KyivRoboMagic/WRO-2024/KyivRoboMagic team photo 2024.jpg

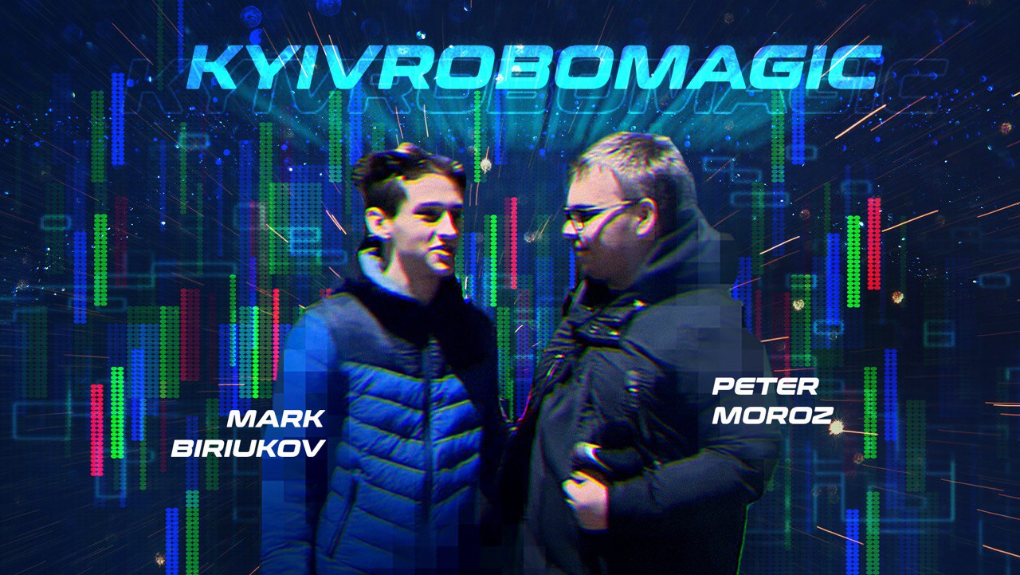
KyivRoboMagic team photo 2024.jpg
