KyivRoboMagic/WRO-2024/Robot.jpg

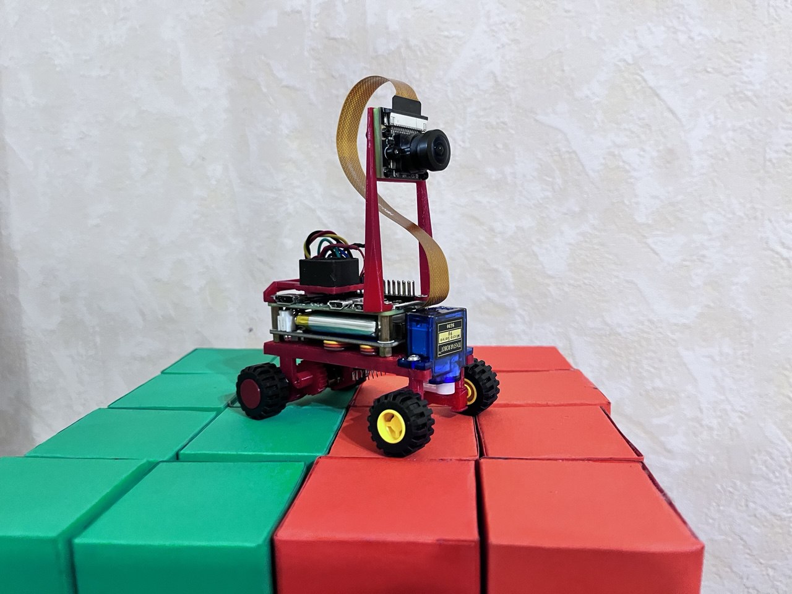
Robot.jpg
