KyivRoboMagic/WRO-2024/README.md

This is WRO 2024 Future Engineers Github repository of Ukrainian team KyivRoboMagic.
