KyivRoboMagic/WRO-2024/Robot STL files/README.txt

Robot parts are designed by KyivRoboMagic team, and are 3D printed
