KyivRoboMagic/WRO-2024/Robot photos/Robot Back.jpg

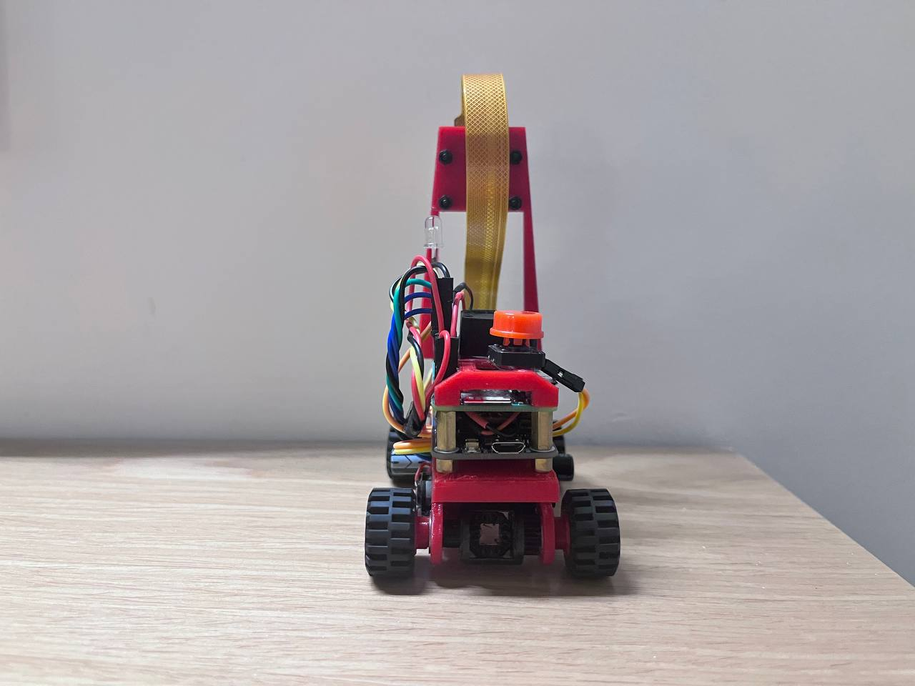
Robot photos/Robot Back.jpg
