KyivRoboMagic/WRO-2024/Robot photos/Robot Bottom.jpg

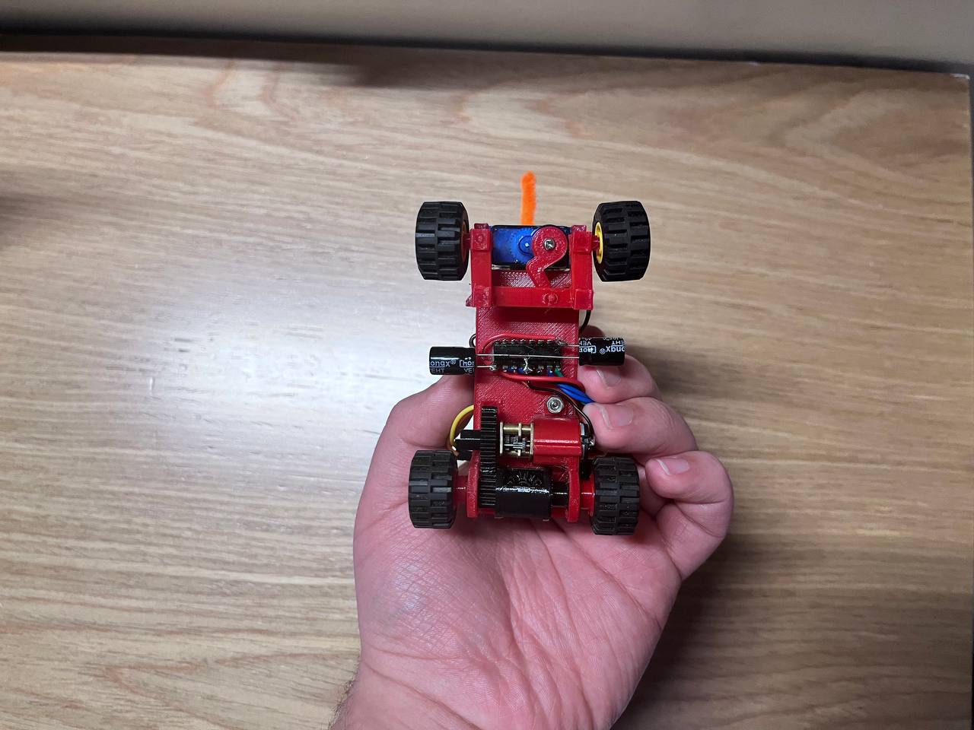
Robot photos/Robot Bottom.jpg
