KyivRoboMagic/WRO-2024/Robot photos/Robot Forward.jpg

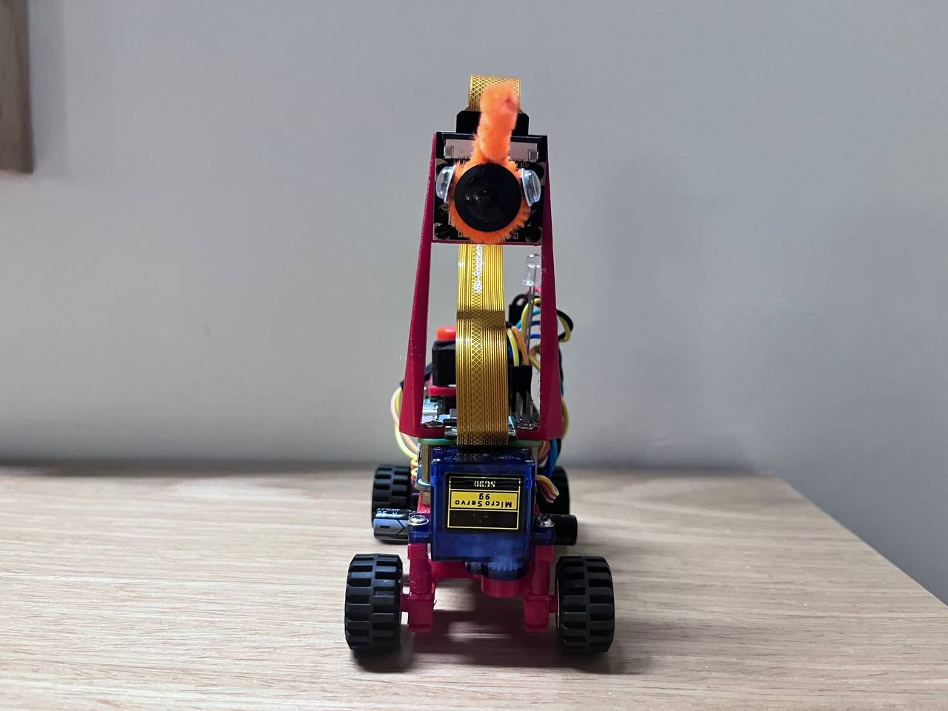
Robot photos/Robot Forward.jpg
