KyivRoboMagic/WRO-2024/Robot photos/Robot Left.jpg

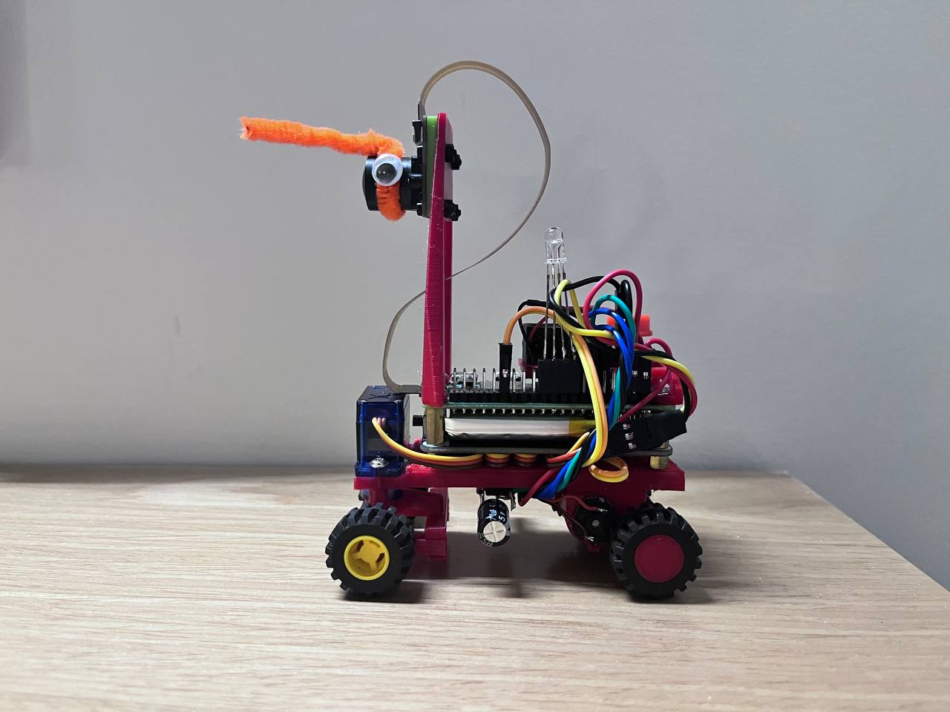
Robot photos/Robot Left.jpg
