KyivRoboMagic/WRO-2024/Robot photos/Robot Photo.jpg

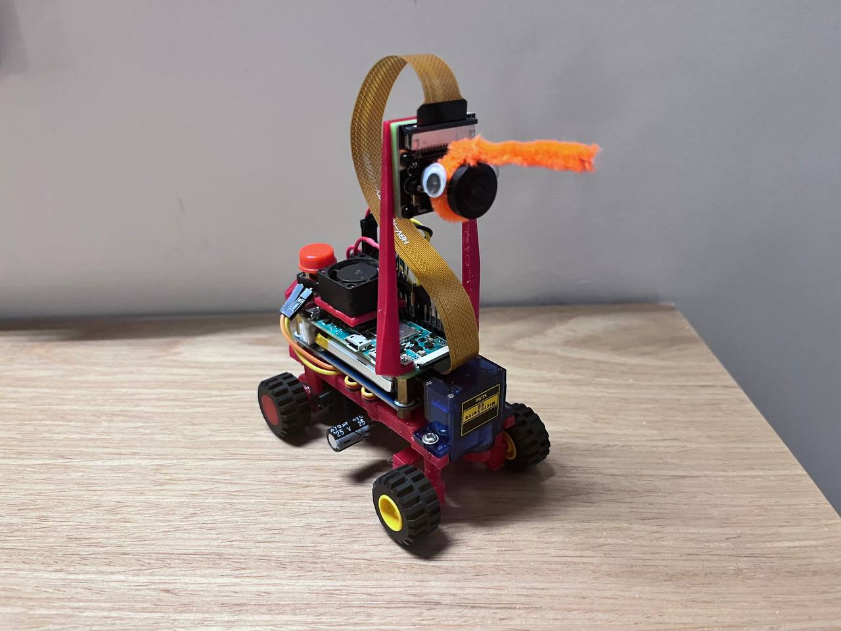
Robot photos/Robot Photo.jpg
