KyivRoboMagic/WRO-2024/Robot photos/Robot Right.jpg

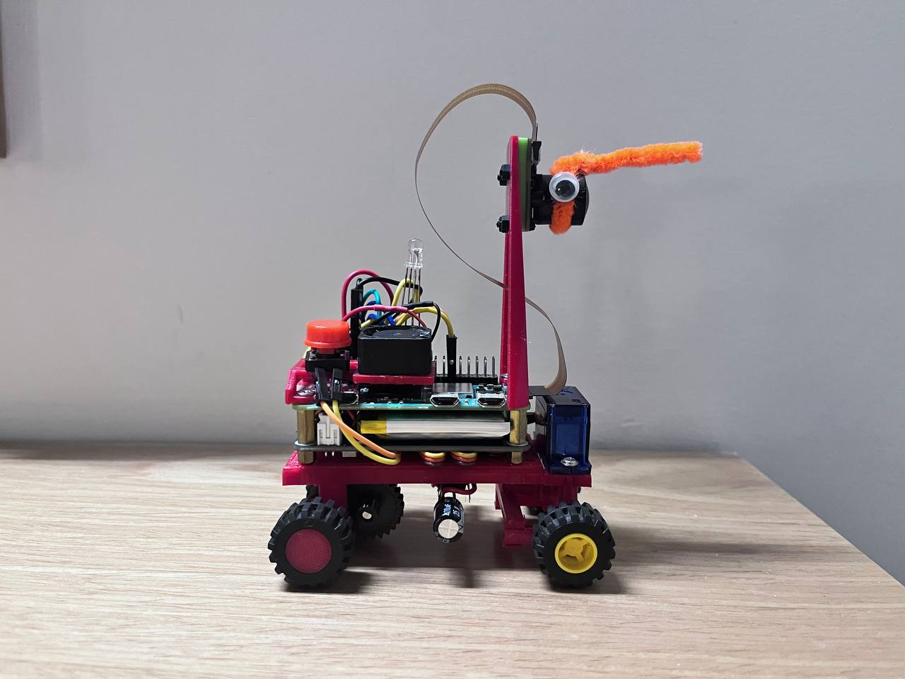
Robot photos/Robot Right.jpg
