KyivRoboMagic/WRO-2024/Robot photos/Robot Top.jpg

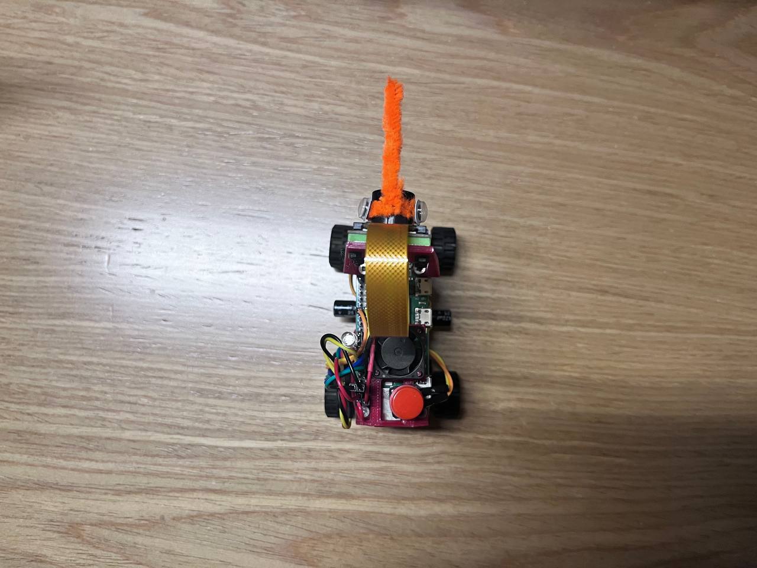
Robot photos/Robot Top.jpg
