KyivRoboMagic/WRO-2024/Robot_photo_new.jpg

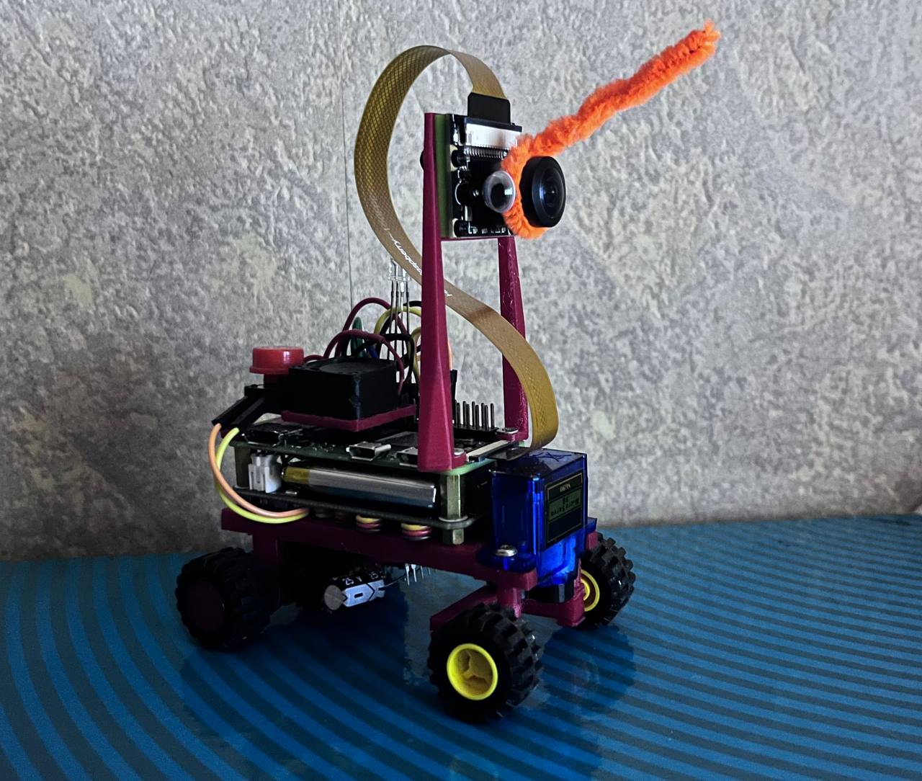
Robot_photo_new.jpg
