KyivRoboMagic/WRO-2024/Robot STL files/Turn Assembly v7.stl

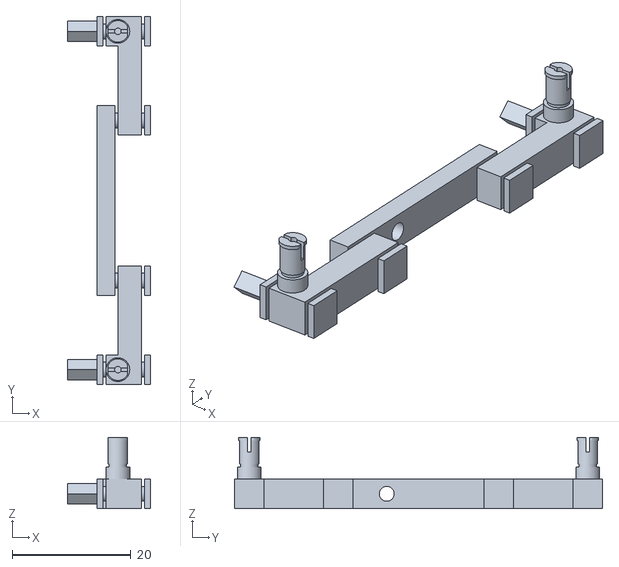
[picture p26: CAD file, 2024-11-27]
Robot STL files/Turn Assembly v7.stl
14.0 x 62.0 x 12.0
