KyivRoboMagic/WRO-2024/Robot STL files/Door.stl

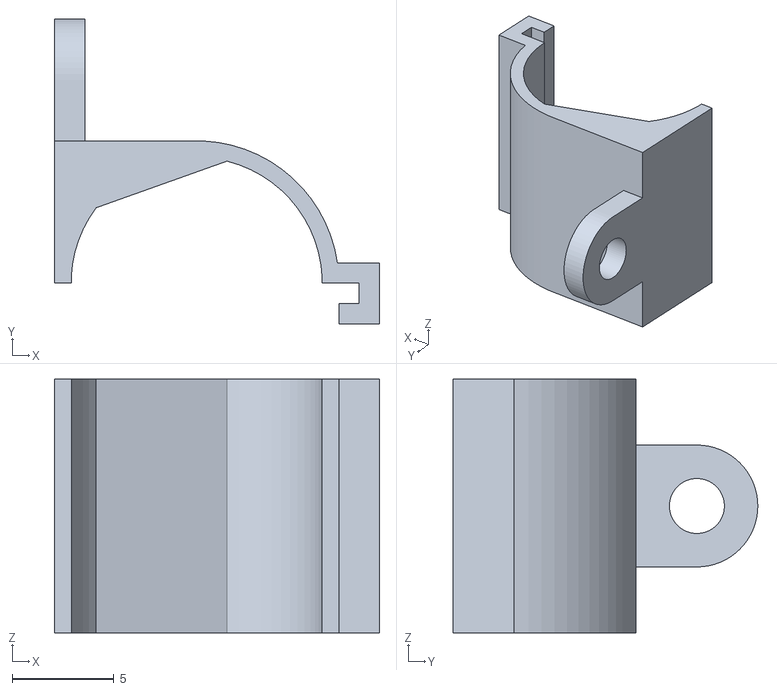
[picture p27: CAD file, 2024-11-27]
Robot STL files/Door.stl
16.0 x 15.0 x 12.5
