KyivRoboMagic/WRO-2024/Robot STL files/Fan Connector.stl

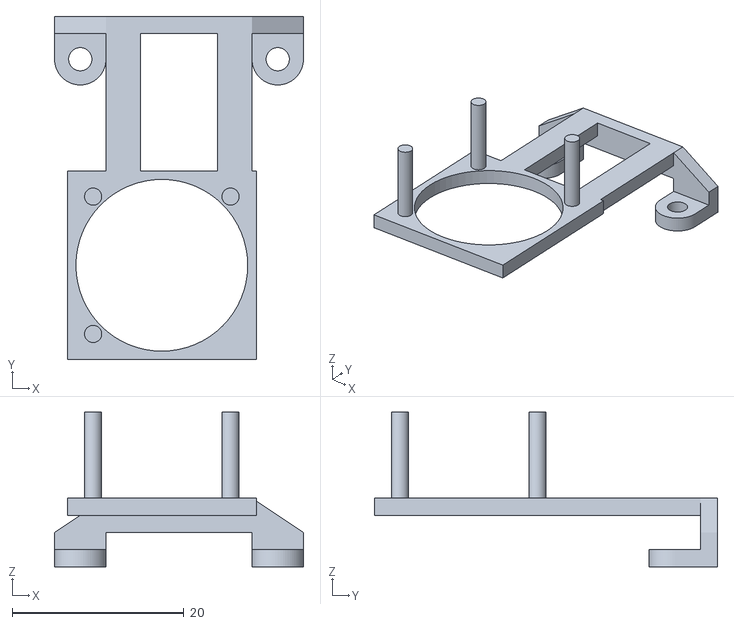
[picture p28: CAD file, 2024-11-27]
Robot STL files/Fan Connector.stl
29.0 x 40.0 x 18.0
