KyivRoboMagic/WRO-2024/Robot STL files/Camera Connector.stl

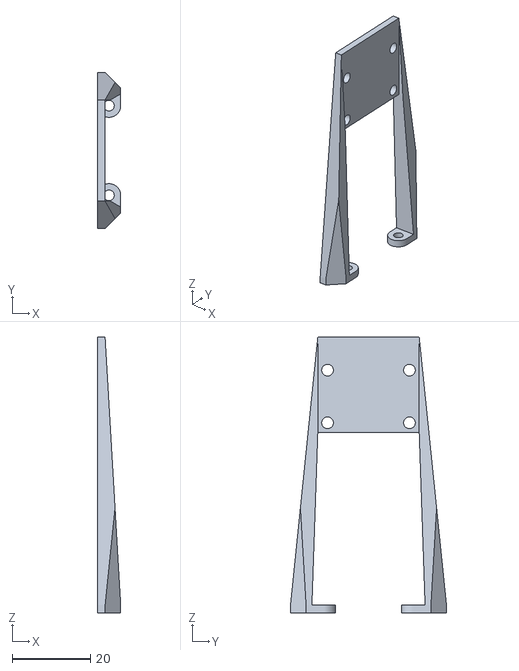
[picture p29: CAD file, 2024-11-27]
Robot STL files/Camera Connector.stl
6.00 x 40.0 x 70.8
