KyivRoboMagic/WRO-2024/Robot STL files/Base.stl

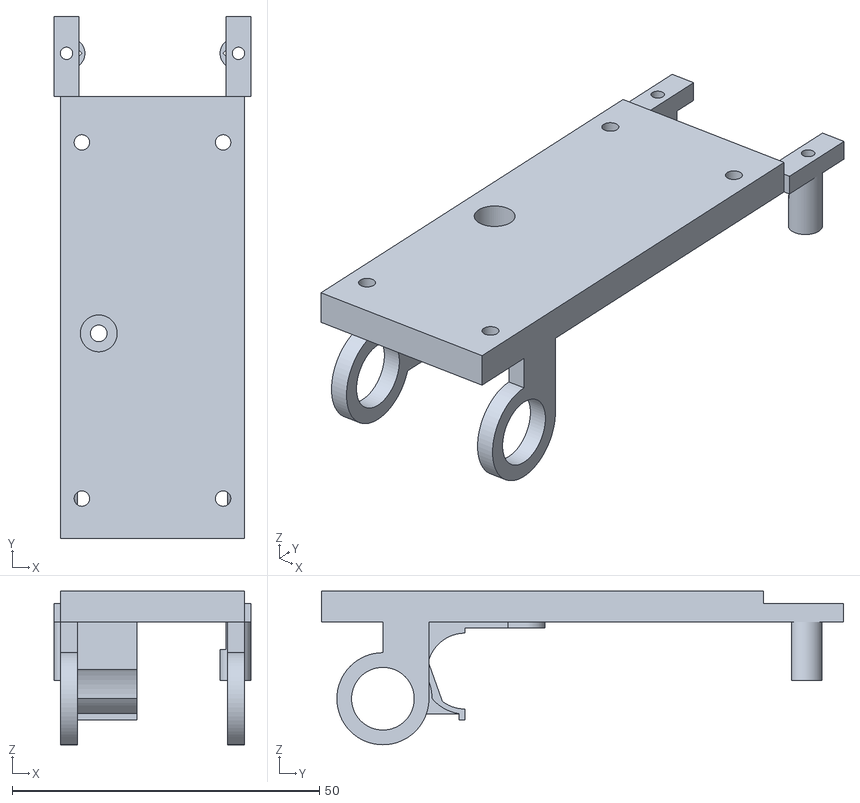
[picture p30: CAD file, 2024-11-27]
Robot STL files/Base.stl
32.0 x 85.0 x 25.0
