KyivRoboMagic/WRO-2024/Robot STL files/Motor Gear.stl

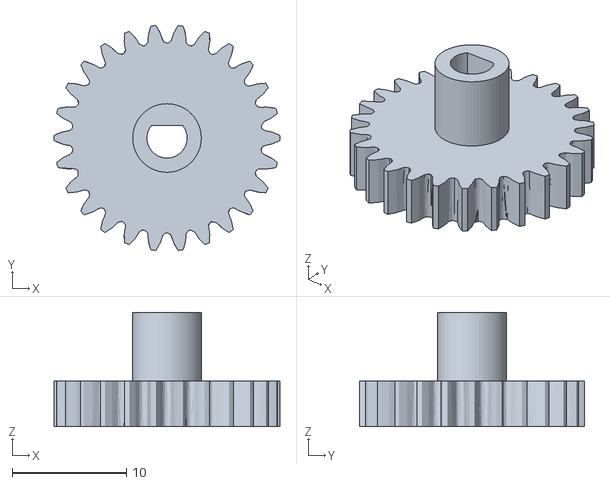
[picture p31: CAD file, 2024-11-27]
Robot STL files/Motor Gear.stl
19.8 x 19.7 x 10.0
