KyivRoboMagic/WRO-2024/Robot STL files/Axle Gear v3.stl

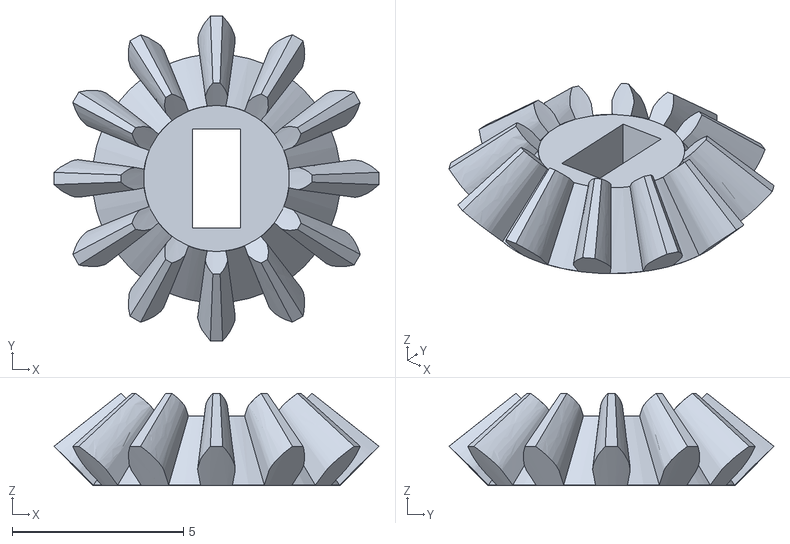
[picture p32: CAD file, 2024-11-27]
Robot STL files/Axle Gear v3.stl
9.50 x 9.50 x 2.70
