KyivRoboMagic/WRO-2024/Robot STL files/Differential.stl

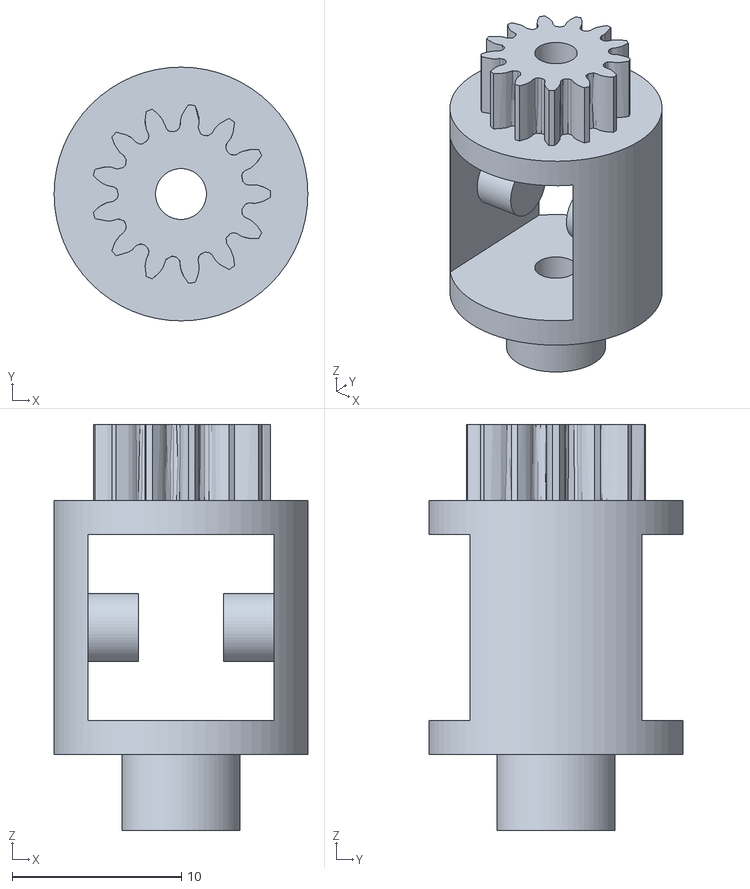
[picture p33: CAD file, 2024-11-27]
Robot STL files/Differential.stl
15.0 x 15.0 x 24.0
