KyivRoboMagic/WRO-2024/Robot STL files/Wheel Axle v8b.stl

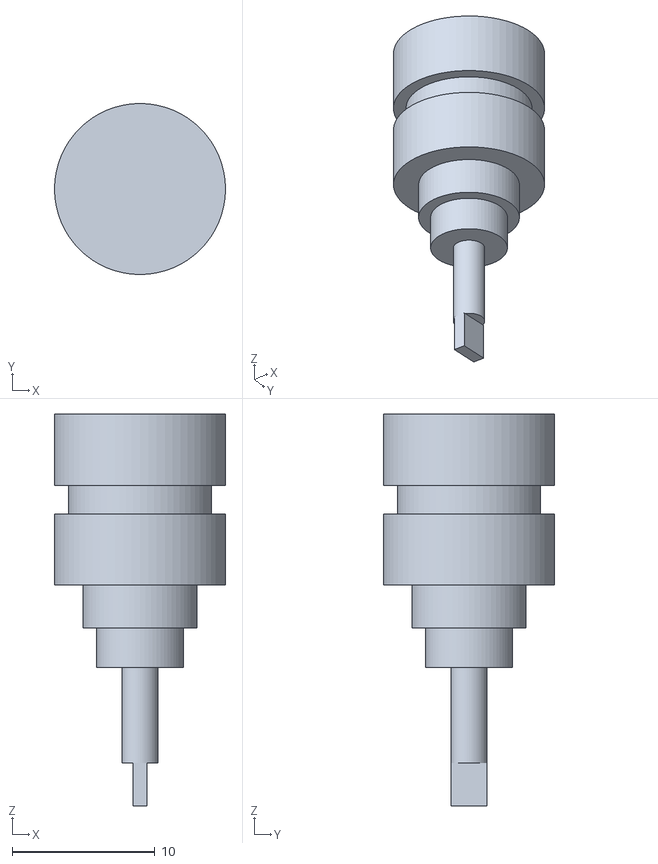
[picture p34: CAD file, 2024-11-27]
Robot STL files/Wheel Axle v8b.stl
12.0 x 12.0 x 27.5
