KyivRoboMagic/WRO-2024/Robot STL files/Servo Arm.stl

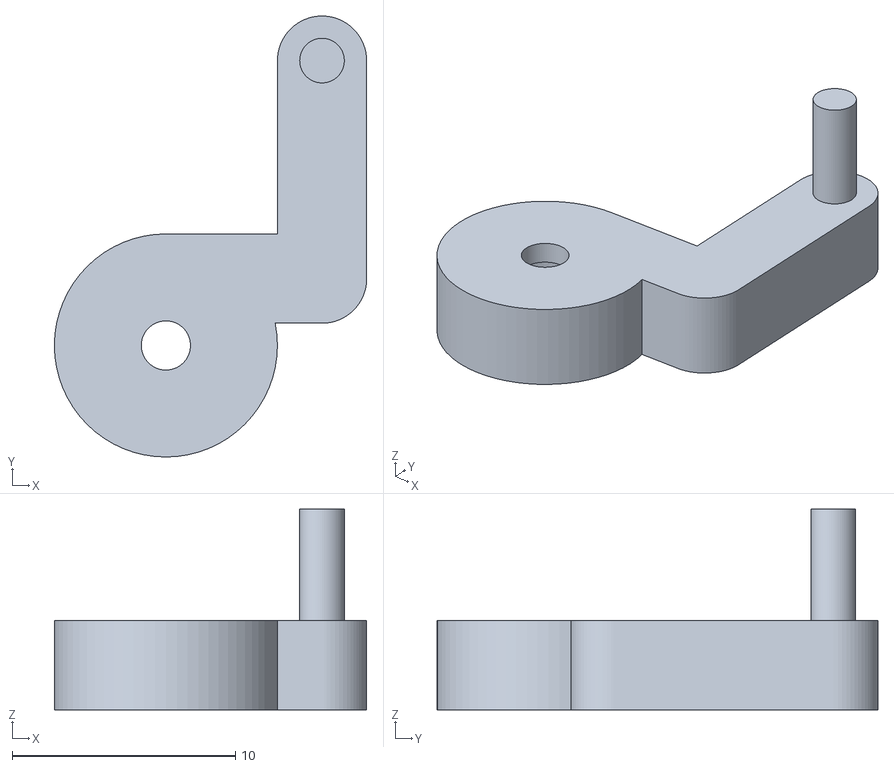
[picture p35: CAD file, 2024-11-27]
Robot STL files/Servo Arm.stl
14.0 x 19.8 x 9.00
