KyivRoboMagic/WRO-2024/Robot STL files/Gear v3.stl

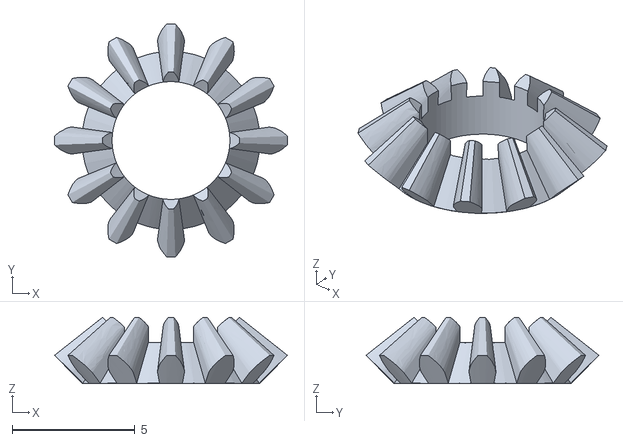
[picture p36: CAD file, 2024-11-27]
Robot STL files/Gear v3.stl
9.50 x 9.50 x 2.70
