KyivRoboMagic/WRO-2024/(commit log)

2024-11-27 Created robot STL folder
2024-11-27 Uploaded robot STL files
    [Axle Gear v3.stl, Base.stl, Camera Connector.stl, Differential.stl, Door.stl, Fan Connector.stl, Gear v3.stl, Motor Gear.stl]
